AYUSH-pro-grammer/stm-devboard/bom.csv

Quantity | Part Name | Link | Unit Price (USD) | Order Cost (USD)
100 | 30pF ±5% 50V C0G 0603 Ceramic Capacitor — TCC0603COG300J500CT (C376782) | https://www.lcsc.com/product-detail/C376782.html | 0.0042 | 0.42
20 | Red 0603 LED — DY-0603SRC-L-SMG (C524047) | https://www.lcsc.com/product-detail/C524047.html | 0.0252 | 0.50
20 | 1N5819 40V 1A Through-Hole DO-41 Diode (C2474) | https://www.lcsc.com/product-detail/C2474.html | 0.0367 | 0.73
10 | 2.2uF 16V X7R 0805 Ceramic Capacitor — CC0805KKX7R7BB225 (C107128) | https://www.lcsc.com/product-detail/C107128.html | 0.0601 | 0.60
20 | 1uF 16V X7R 0805 Ceramic Capacitor — 0805B105K160CT (C396719) | https://www.lcsc.com/product-detail/C396719.html | 0.0457 | 0.91
10 | 4.7uF 25V X7R 0805 Ceramic Capacitor — CC0805MKX7R8BB475 (C5185457) | https://www.lcsc.com/product-detail/C5185457.html | 0.0717 | 0.72
50 | 10pF ±5% 50V NP0 0603 Ceramic Capacitor — AC0603JRNPO9BN100 (C277527) | https://www.lcsc.com/product-detail/C277527.html | 0.0106 | 0.53
5 | 10uF 10V X7R 0805 Ceramic Capacitor — TCC0805X7R106K100FT (C380346) | https://www.lcsc.com/product-detail/C380346.html | 0.0918 | 0.46
20 | 100nF 50V X7R 0603 Ceramic Capacitor — CC0603JRX7R9BB104 (C91183) | https://www.lcsc.com/product-detail/C91183.html | 0.0209 | 0.42
50 | Green 0603 LED — KT-0603G (C12624) | https://www.lcsc.com/product-detail/C12624.html | 0.0124 | 0.62
50 | Blue 0603 LED — KT-0603B (C2288) [BACKORDERED] | https://www.lcsc.com/product-detail/C2288.html | 0.0104 | 0.52
1 | USB-C USB 2.0 Receptacle, USB4105-GF-A-060 (C3025063) [BACKORDERED] | https://www.lcsc.com/product-detail/C3025063.html | 1.4727 | 1.47
20 | 1x4 2.54mm Through-Hole Pin Header — PZ254V-11-04P (C2691448) | https://www.lcsc.com/product-detail/C2691448.html | 0.0263 | 0.53
10 | 1x6 2.54mm Through-Hole Pin Header — 2.54-1x6P (C37208) | https://www.lcsc.com/product-detail/C37208.html | 0.0419 | 0.42
5 | DMG1012T-7 N-Channel MOSFET SOT-523 (C20512) | https://www.lcsc.com/product-detail/C20512.html | 0.1019 | 0.51
20 | 10kOhm ±1% 0603 Resistor — MCT06030C1002FP500 (C161803) | https://www.lcsc.com/product-detail/C161803.html | 0.0377 | 0.75
10 | 5.1kOhm ±0.1% 0603 Resistor — HoAR0603-1/10W-5.1KR-0.1%-TCR25 (C5123587) | https://www.lcsc.com/product-detail/C5123587.html | 0.0728 | 0.73
20 | 1.4kOhm ±0.1% 0603 Resistor — RT0603BRD071K4L (C705740) | https://www.lcsc.com/product-detail/C705740.html | 0.0596 | 1.19
10 | 1.1kOhm ±0.1% 0603 Resistor — RT0603BRD071K1L (C705736) | https://www.lcsc.com/product-detail/C705736.html | 0.0508 | 0.51
1 | 160Ohm ±1% 0603 Resistor — ERJP03F1600V (C543226) [BACKORDERED] | https://www.lcsc.com/product-detail/C543226.html | 0.0598 | 0.06
1 | 221Ohm ±1% 0603 Resistor — ERJ-S03F2210V (C2113629) [BACKORDERED] | https://www.lcsc.com/product-detail/C2113629.html | 0.0270 | 0.03
5 | USBLC6-2P6 USB ESD Protection IC SOT-666 (C15999) [BACKORDERED] | https://www.lcsc.com/product-detail/C15999.html | 0.2491 | 1.25
5 | LD1117S33TR 3.3V LDO Regulator SOT-223 (C86781) | https://www.lcsc.com/product-detail/C86781.html | 0.2467 | 1.23
5 | 8MHz ±20ppm 18pF SMD3225 4-pad Crystal — 0132M4-8.000F18DTNL (C51949868) | https://www.lcsc.com/product-detail/C51949868.html | 0.1920 | 0.96
1 | STM32H573RIT6 MCU LQFP-64 10x10mm (C22371377) [BACKORDERED] | https://www.lcsc.com/product-detail/C22371377.html | 9.9787 | 9.98
50 | 6x6mm Through-Hole Tactile Switch — SH-6X6X5H-STM (C22383475) | https://www.lcsc.com/product-detail/C22383475.html | 0.0115 | 0.58
1 | PCB Fabrication — Custom STM32H573 PCB (JLCPCB) | https://jlcpcb.com/ | 8.00 | 8.00
