AYUSH-pro-grammer/stm-devboard/stm-devboard/stm-devboard.kicad_pcb

## KiCad design stm-devboard/stm-devboard.kicad_pcb (2026-10-09)

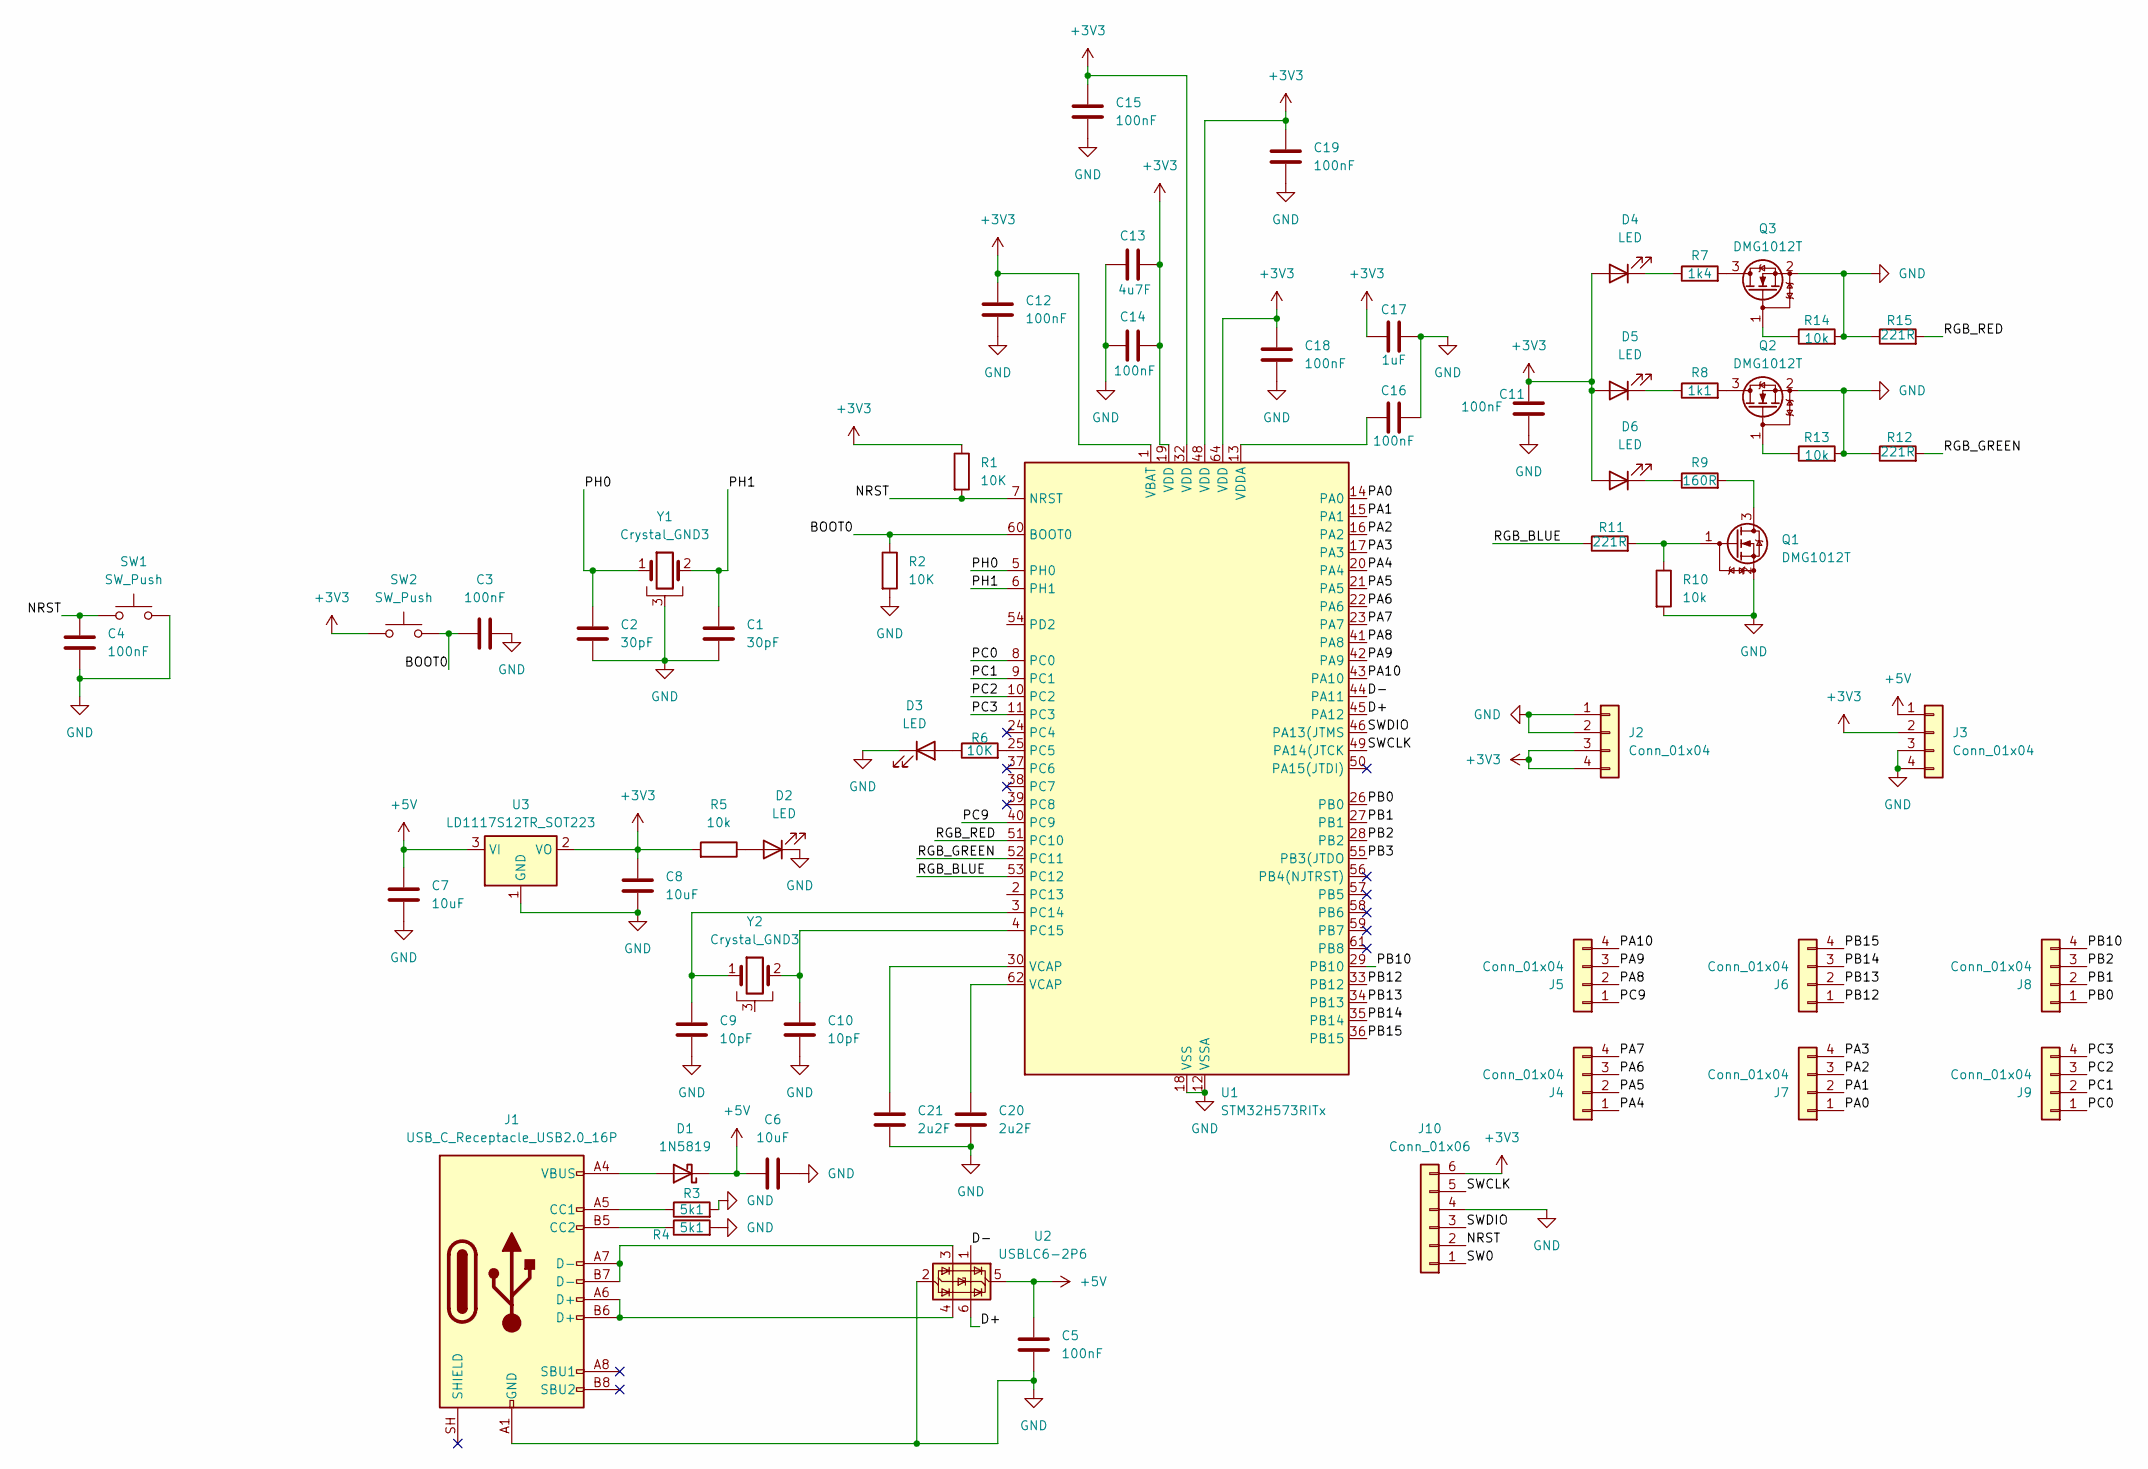
[picture p5: schematic stm-devboard.kicad_sch]

Parts:
C1, C2: 30pF; C_0603_1608Metric
C3, C4, C5, C11, C12, C14, C15, C16, C18, C19: 100nF; C_0603_1608Metric
C6, C7, C8: 10uF; C_0805_2012Metric
C9, C10: 10pF; C_0603_1608Metric
C13: 4u7F; C_0805_2012Metric
C17: 1uF; C_0805_2012Metric
C20, C21: 2u2F; C_0805_2012Metric
D1: 1N5819; D_DO-41_SOD81_P10.16mm_Horizontal
D2, D3, D4, D5, D6: LED; LED_0603_1608Metric
J1: USB_C_Receptacle_USB2.0_16P; USB_C_Receptacle_GCT_USB4105-xx-A_16P_TopMnt_Horizontal
J2, J3, J4, J5, J6, J7, J8, J9: Conn_01x04; PinHeader_1x04_P2.54mm_Vertical
J10: Conn_01x06; PinHeader_1x06_P2.54mm_Vertical
Q1, Q2, Q3: DMG1012T; SOT-523
R1, R2, R6: 10K; R_0603_1608Metric
R3, R4: 5k1; R_0603_1608Metric
R5, R10, R13, R14: 10k; R_0603_1608Metric
R7: 1k4; R_0603_1608Metric
R8: 1k1; R_0603_1608Metric
R9: 160R; R_0603_1608Metric
R11, R12, R15: 221R; R_0603_1608Metric
SW1, SW2: SW_Push; SW_PUSH_6mm
U1: STM32H573RITx; LQFP-64_10x10mm_P0.5mm
U2: USBLC6-2P6; SOT-666
U3: LD1117S12TR_SOT223; SOT-223-3_TabPin2
Y1, Y2: Crystal_GND3; Crystal_SMD_3225-4Pin_3.2x2.5mm

Connections:
+3V3: C8.1, C11.1, C12.1, C13.2, C14.2, C15.1, C17.1, C18.1, C19.1, D4.2 (A), D5.2 (A), D6.2 (A), J2.3, J2.4, J3.2, J10.6, R1.1, R5.2, SW2.1, U1.1 (VBAT), U1.19 (VDD), U1.32 (VDD), U1.48 (VDD), U1.64 (VDD), U3.2 (VO)
+5V: C5.1, C6.1, C7.2, D1.1 (K), J3.1, U2.5 (VBUS), U3.3 (VI)
/BOOT0: C3.1, R2.1, SW2.2, U1.60 (BOOT0)
/D+: U1.45 (PA12), U2.6 (I/O1)
/D-: U1.44 (PA11), U2.1 (I/O1)
/NRST: C4.2, J10.2, R1.2, SW1.1, U1.7 (NRST)
/PA0: J7.1, U1.14 (PA0)
/PA1: J7.2, U1.15 (PA1)
/PA2: J7.3, U1.16 (PA2)
/PA3: J7.4, U1.17 (PA3)
/PA4: J4.1, U1.20 (PA4)
/PA5: J4.2, U1.21 (PA5)
/PA6: J4.3, U1.22 (PA6)
/PA7: J4.4, U1.23 (PA7)
/PA8: J5.2, U1.41 (PA8)
/PA9: J5.3, U1.42 (PA9)
/PA10: J5.4, U1.43 (PA10)
/PB0: J8.1, U1.26 (PB0)
/PB1: J8.2, U1.27 (PB1)
/PB2: J8.3, U1.28 (PB2)
/PB3: U1.55 (PB3(JTDO)
/PB10: J8.4, U1.29 (PB10)
/PB12: J6.1, U1.33 (PB12)
/PB13: J6.2, U1.34 (PB13)
/PB14: J6.3, U1.35 (PB14)
/PB15: J6.4, U1.36 (PB15)
/PC0: J9.1, U1.8 (PC0)
/PC1: J9.2, U1.9 (PC1)
/PC2: J9.3, U1.10 (PC2)
/PC3: J9.4, U1.11 (PC3)
/PC9: J5.1, U1.40 (PC9)
/PH0: C2.1, U1.5 (PH0), Y1.1
/PH1: C1.1, U1.6 (PH1), Y1.2
/RGB_BLUE: R11.1, U1.53 (PC12)
/RGB_GREEN: R12.2, U1.52 (PC11)
/RGB_RED: R15.2, U1.51 (PC10)
/SW0: J10.1
/SWCLK: J10.5, U1.49 (PA14(JTCK)
/SWDIO: J10.3, U1.46 (PA13(JTMS)
unnamed: C20.1, U1.62 (VCAP)
unnamed: C21.1, U1.30 (VCAP)
unnamed: D1.2 (A), J1.A4 (VBUS), J1.A9 (VBUS), J1.B4 (VBUS), J1.B9 (VBUS)
unnamed: D2.2 (A), R5.1
unnamed: D3.2 (A), R6.1
unnamed: D4.1 (K), R7.1
unnamed: D5.1 (K), R8.1
unnamed: D6.1 (K), R9.1
unnamed: J1.A5 (CC1), R3.1
unnamed: J1.B5 (CC2), R4.1
unnamed: J1.A6 (D+), J1.B6 (D+), U2.4 (I/O2)
unnamed: J1.A7 (D-), J1.B7 (D-), U2.3 (I/O2)
unnamed: Q1.3 (D), R9.2
unnamed: Q1.1 (G), R10.1, R11.2
unnamed: Q2.3 (D), R8.2
unnamed: Q3.3 (D), R7.2
unnamed: R6.2, U1.25 (PC5)
unnamed: C9.1, U1.3 (PC14), Y2.1
unnamed: C10.1, U1.4 (PC15), Y2.2
unnamed: C16.1, U1.13 (VDDA)

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
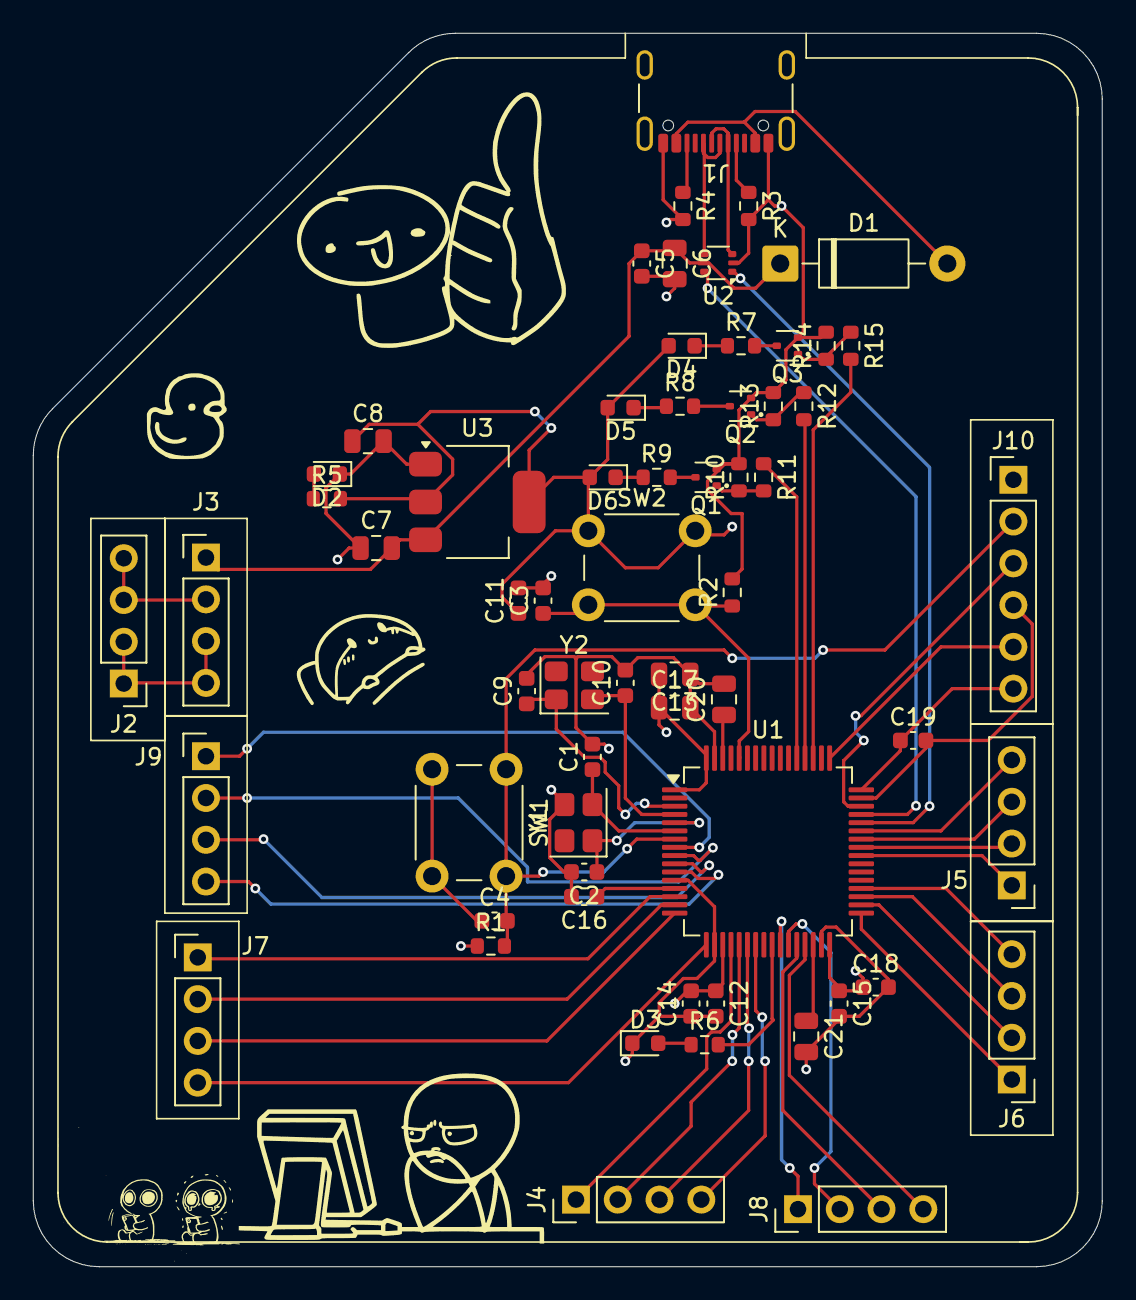
[picture p6: board stm-devboard.kicad_pcb from above]

Board: 4 copper layers, 65.0 x 75.0 mm, 62 parts (0 on the bottom side), 60 nets.
